JinHeMu/smart-car/README.md

# 第十八届智能视觉

本工程包含了软件，硬件和机械结构部分。软件采用RT-Thread实时操作系统，机械结构为凤凰四分类结构，工程仅供参考。
