JinHeMu/smart-car/PCB/SCH_openart显示屏转接板_1-Sheet_1_2023-07-10.png

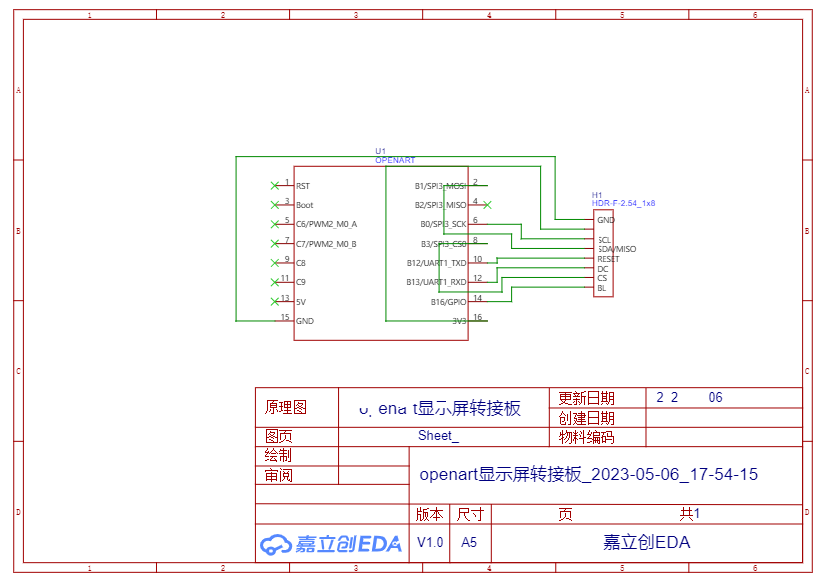
PCB/SCH_openart显示屏转接板_1-Sheet_1_2023-07-10.png
