JinHeMu/smart-car/PCB/SCH_主板_1_1-rt0164主板原理图_2023-07-10.png

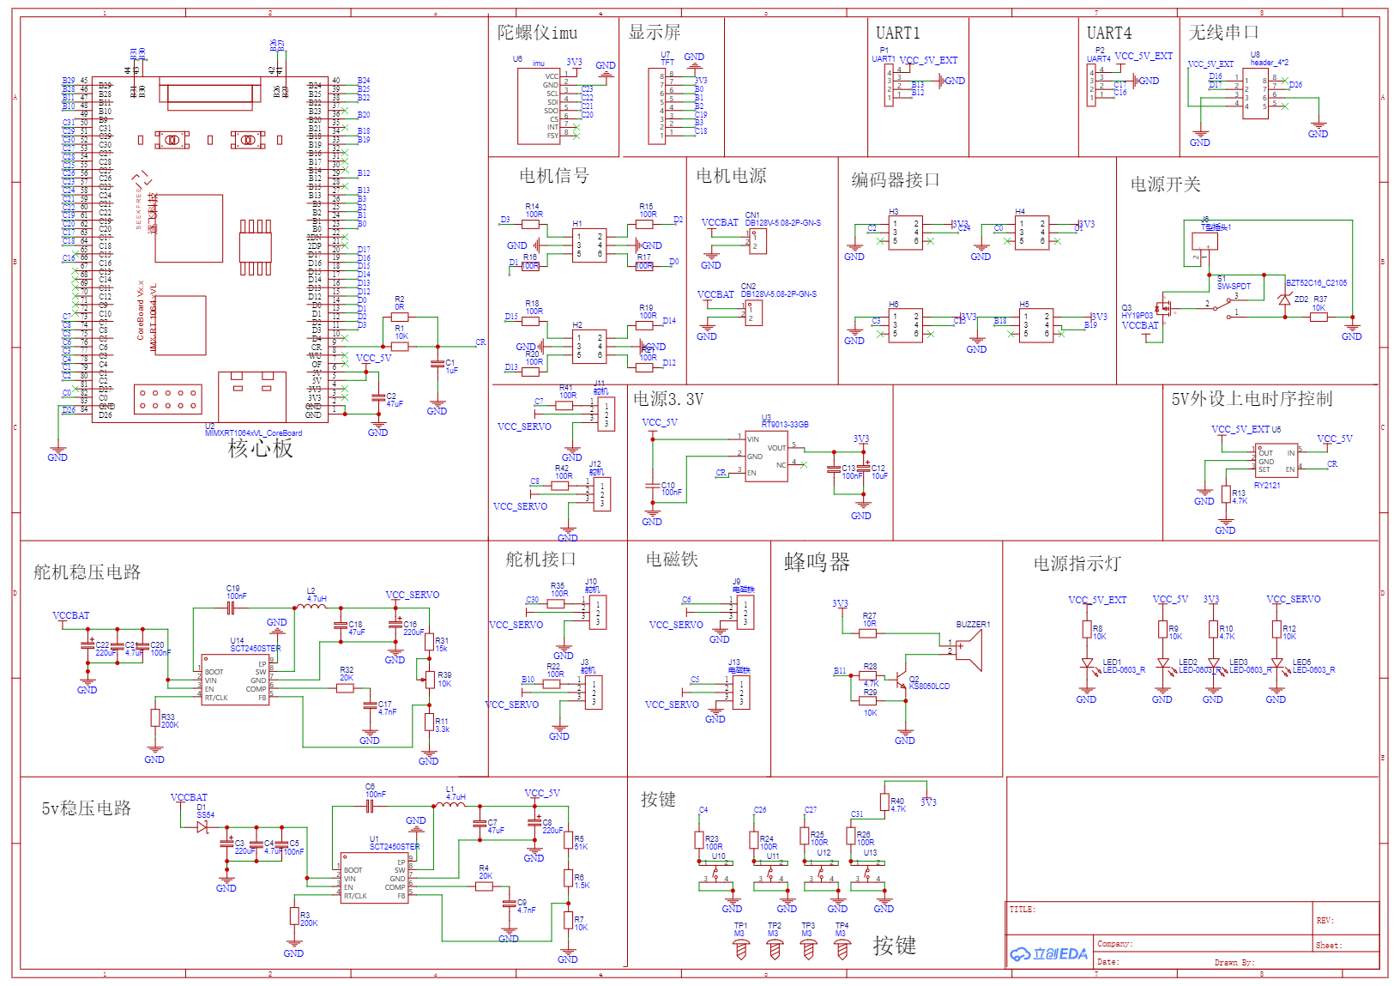
PCB/SCH_主板_1_1-rt0164主板原理图_2023-07-10.png
