JinHeMu/smart-car/PCB/SCH_主板_2_2-rt0164主板原理图_2023-08-16.png

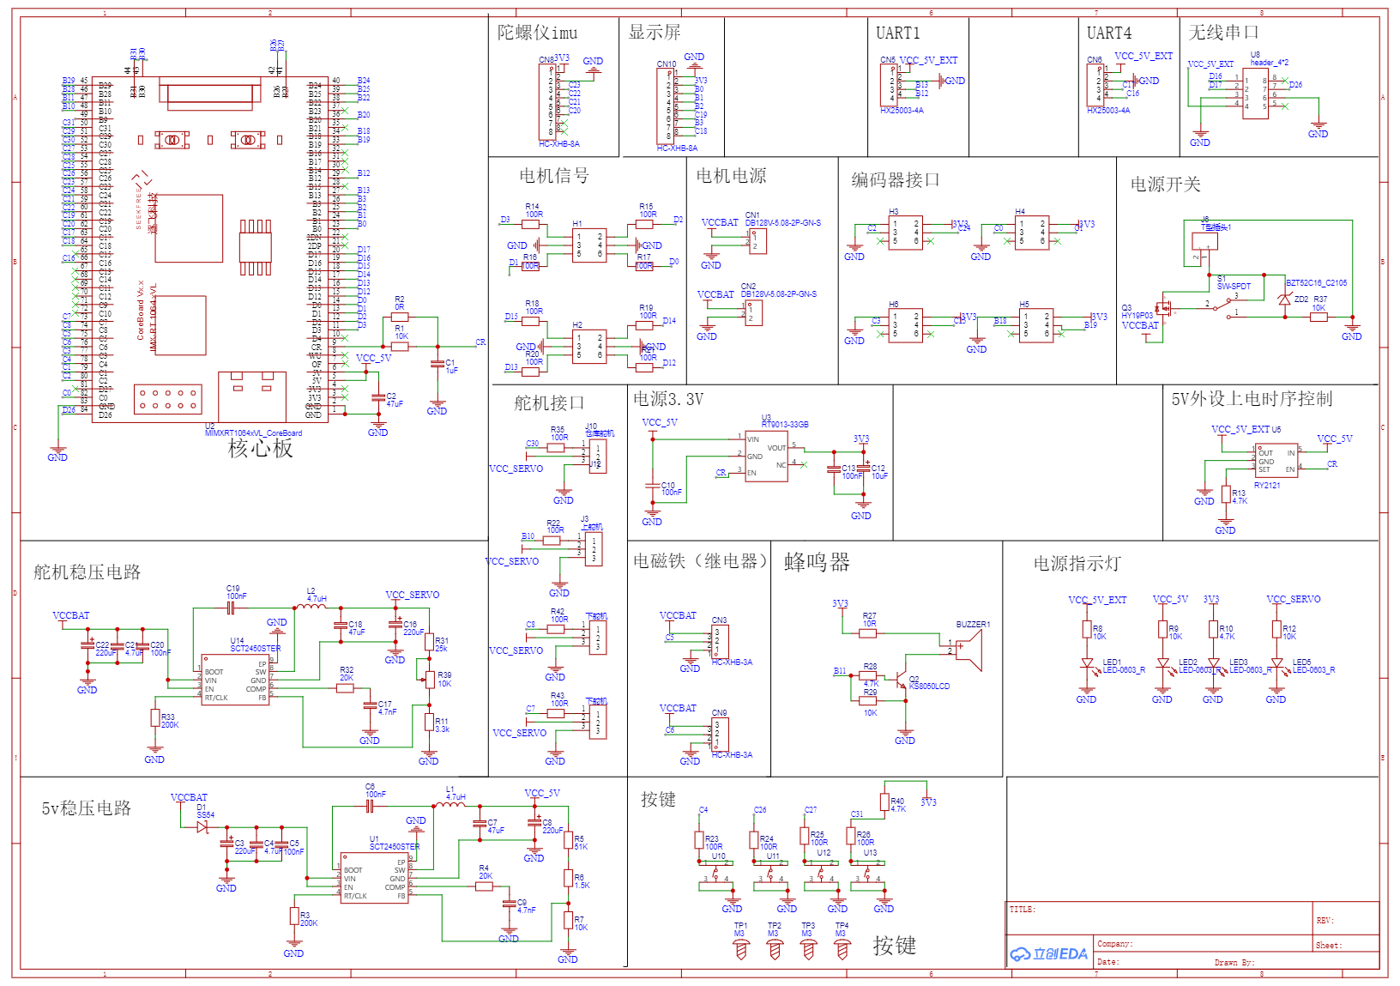
PCB/SCH_主板_2_2-rt0164主板原理图_2023-08-16.png
