JinHeMu/smart-car/PCB/SCH_驱动板_1-DRV8701_2023-07-10.png

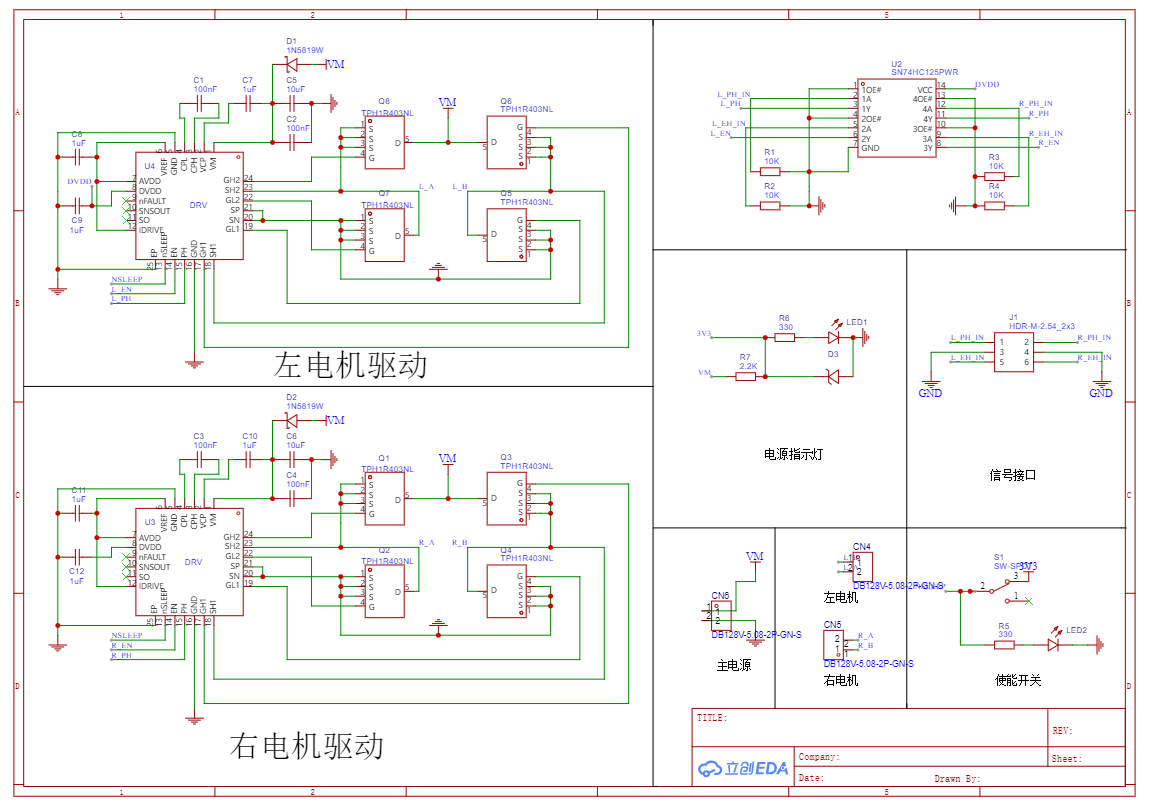
PCB/SCH_驱动板_1-DRV8701_2023-07-10.png
