JinHeMu/smart-car/PCB/继电器原理图.png

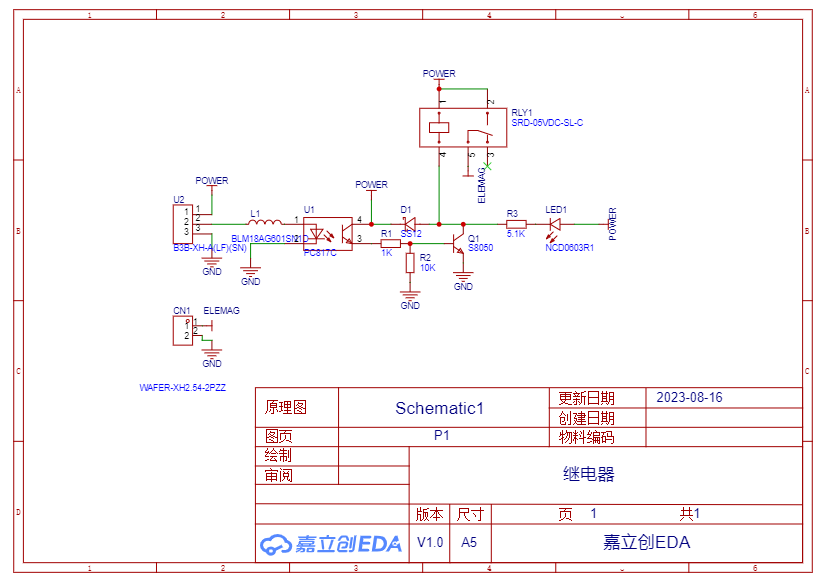
PCB/继电器原理图.png
