JinHeMu/smart-car/model/智能视觉车四分类/仓门.SLDPRT

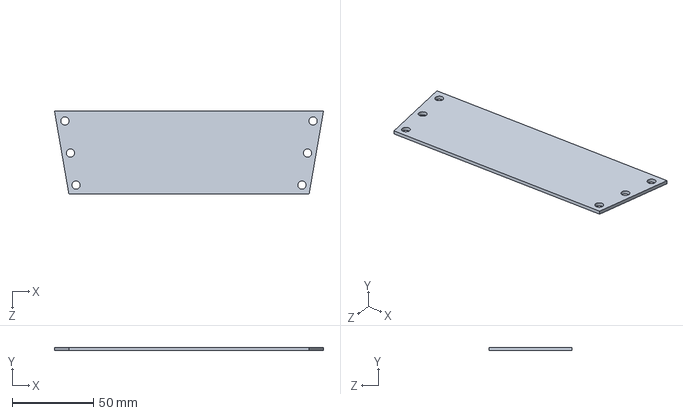
[picture p7: CAD file, 2023-07-11]
model/智能视觉车四分类/仓门.SLDPRT
165.5 x 2.00 x 50.8 mm
