JinHeMu/smart-car/model/智能视觉车四分类/储物仓.SLDPRT

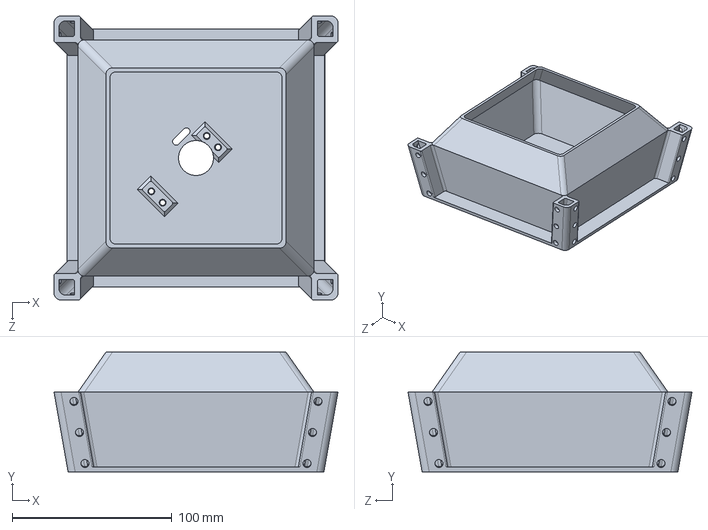
[picture p8: CAD file, 2023-07-11]
model/智能视觉车四分类/储物仓.SLDPRT
177.6 x 75.0 x 177.6 mm
