JinHeMu/smart-car/model/智能视觉车四分类/电池.SLDPRT

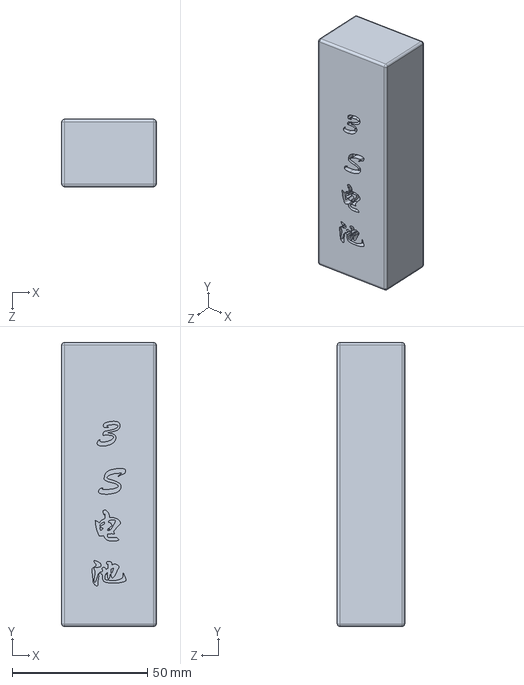
[picture p9: CAD file, 2023-06-17]
model/智能视觉车四分类/电池.SLDPRT
35.0 x 105.0 x 25.0 mm
