JinHeMu/smart-car/model/智能视觉车四分类/舵机1.SLDPRT

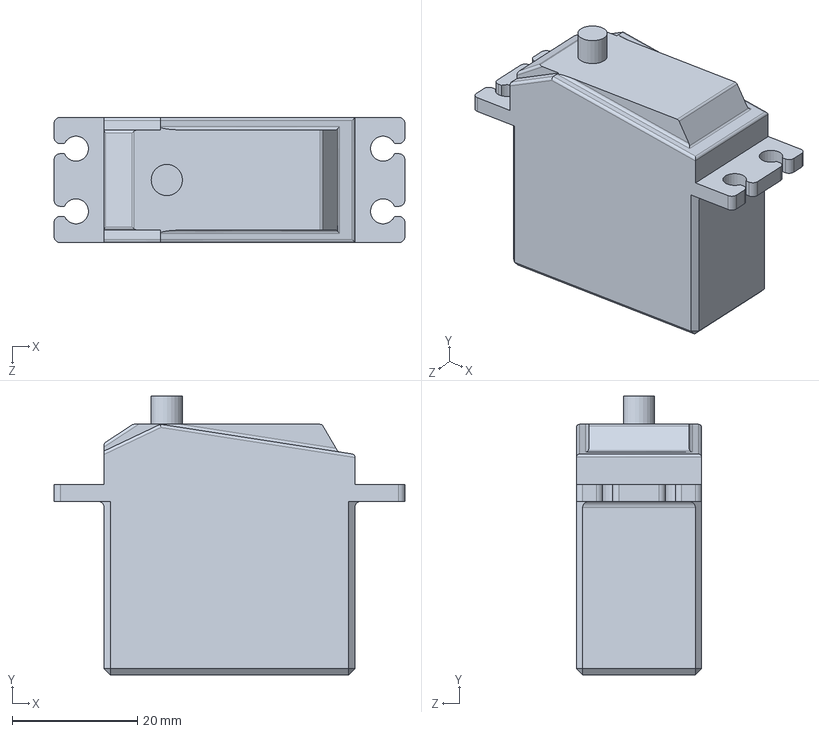
[picture p10: CAD file, 2023-06-17]
model/智能视觉车四分类/舵机1.SLDPRT
56.0 x 44.5 x 20.0 mm
