JinHeMu/smart-car/model/智能视觉车四分类/电路板底板.SLDPRT

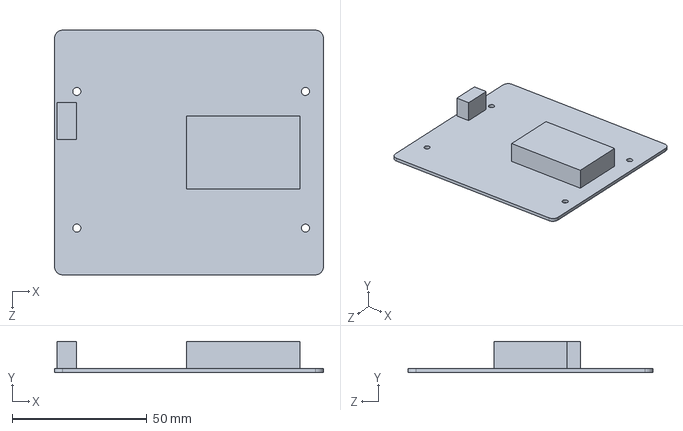
[picture p11: CAD file, 2023-06-17]
model/智能视觉车四分类/电路板底板.SLDPRT
100.0 x 11.6 x 91.0 mm
