JinHeMu/smart-car/model/智能视觉车四分类/摄像头支架2pvc.SLDPRT

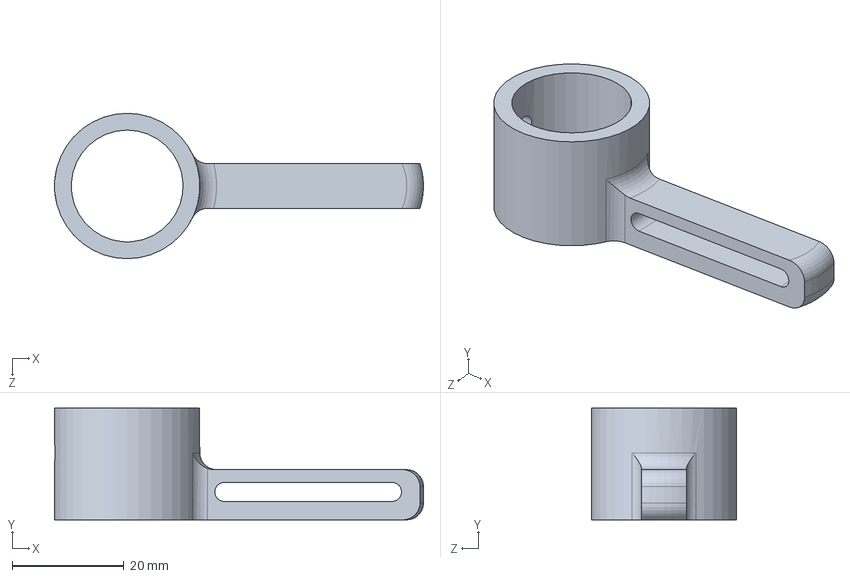
[picture p12: CAD file, 2023-06-17]
model/智能视觉车四分类/摄像头支架2pvc.SLDPRT
66.0 x 20.0 x 26.0 mm
