JinHeMu/smart-car/model/智能视觉车四分类/左侧支架.SLDPRT

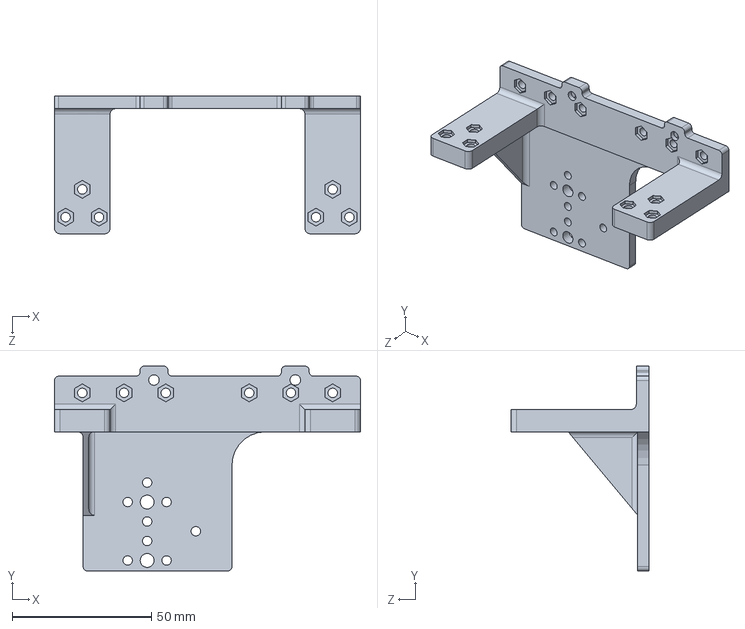
[picture p13: CAD file, 2023-06-17]
model/智能视觉车四分类/左侧支架.SLDPRT
110.0 x 73.6 x 49.5 mm
