JinHeMu/smart-car/model/智能视觉车四分类/前机械臂支架.SLDPRT

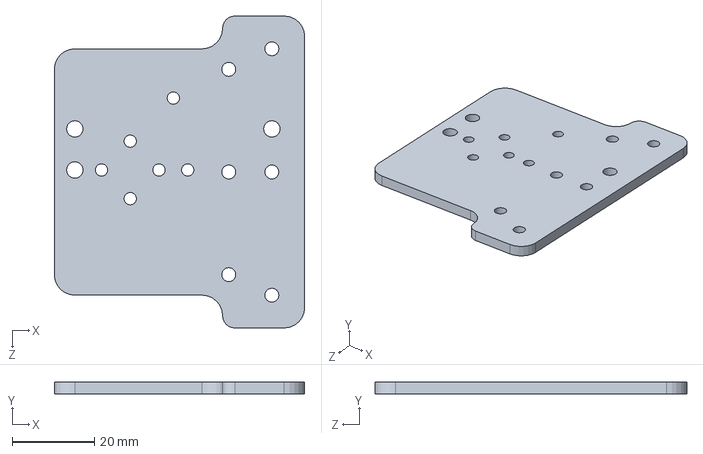
[picture p14: CAD file, 2023-06-17]
model/智能视觉车四分类/前机械臂支架.SLDPRT
61.0 x 3.00 x 76.0 mm
