JinHeMu/smart-car/model/智能视觉车四分类/卡片.SLDPRT

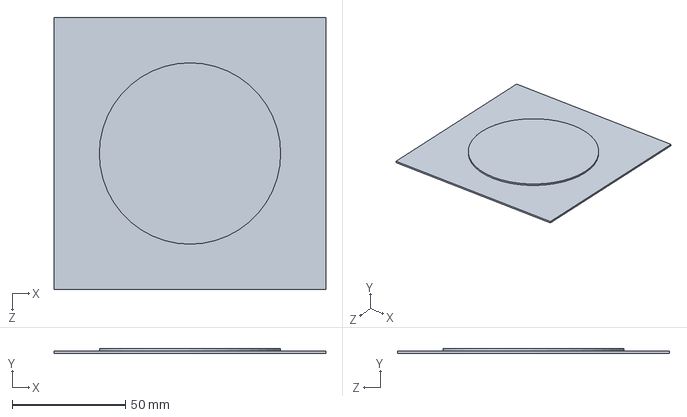
[picture p15: CAD file, 2023-06-17]
model/智能视觉车四分类/卡片.SLDPRT
120.0 x 2.00 x 120.0 mm
