JinHeMu/smart-car/model/智能视觉车四分类/M车底盘.SLDPRT

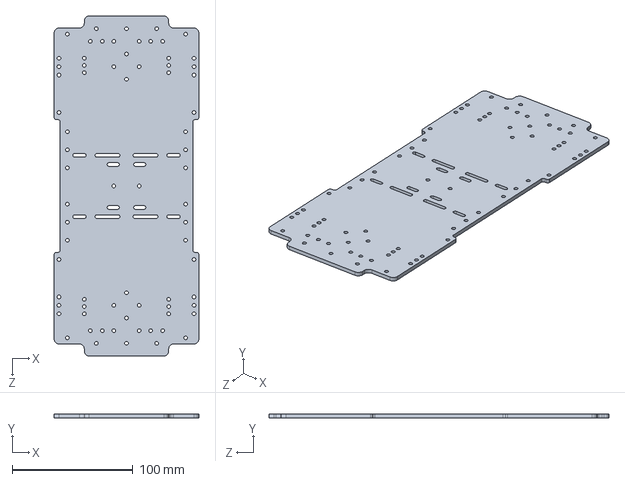
[picture p16: CAD file, 2023-06-17]
model/智能视觉车四分类/M车底盘.SLDPRT
120.0 x 3.00 x 282.0 mm
