JinHeMu/smart-car/model/智能视觉车四分类/长U支架.SLDPRT

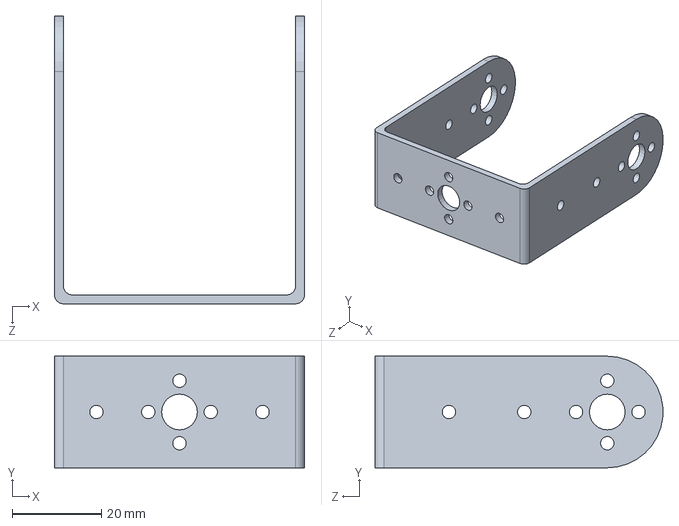
[picture p17: CAD file, 2023-06-17]
model/智能视觉车四分类/长U支架.SLDPRT
56.0 x 25.0 x 64.4 mm
