JinHeMu/smart-car/model/智能视觉车四分类/推力轴承.SLDPRT

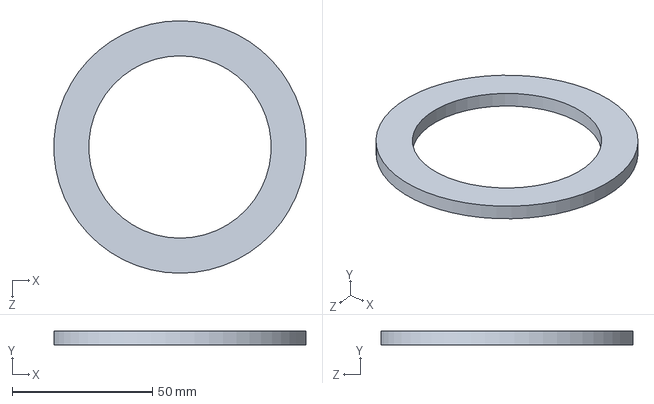
[picture p18: CAD file, 2023-06-17]
model/智能视觉车四分类/推力轴承.SLDPRT
89.8 x 5.00 x 90.0 mm
