JinHeMu/smart-car/model/智能视觉车四分类/逐飞摄像头支架连接件.SLDPRT

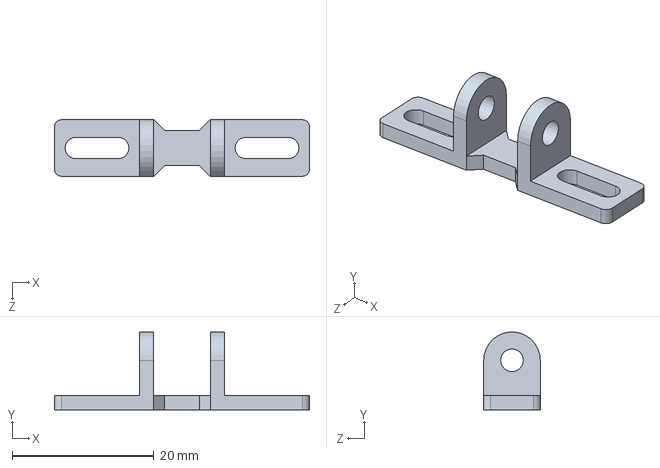
[picture p19: CAD file, 2023-06-17]
model/智能视觉车四分类/逐飞摄像头支架连接件.SLDPRT
36.0 x 11.0 x 8.00 mm
