JinHeMu/smart-car/model/智能视觉车四分类/万能支架.SLDPRT

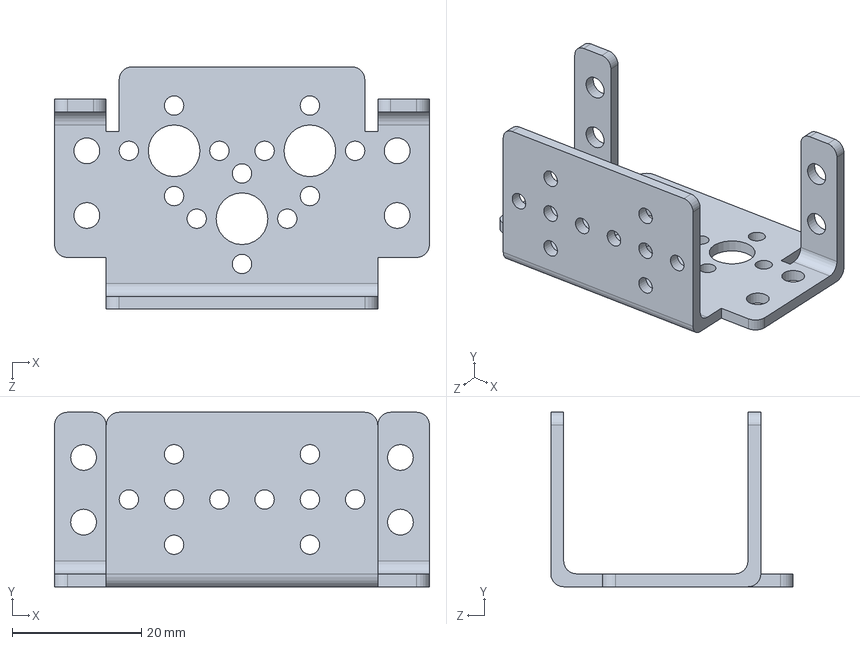
[picture p20: CAD file, 2023-06-17]
model/智能视觉车四分类/万能支架.SLDPRT
58.0 x 27.0 x 37.5 mm
