JinHeMu/smart-car/model/智能视觉车四分类/储物仓支架.SLDPRT

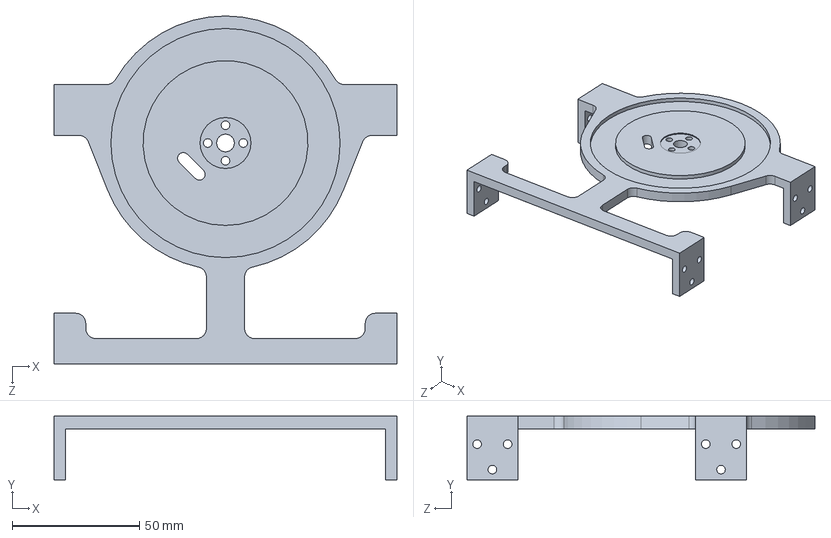
[picture p21: CAD file, 2023-06-17]
model/智能视觉车四分类/储物仓支架.SLDPRT
135.0 x 25.0 x 137.0 mm
