JinHeMu/smart-car/model/智能视觉车四分类/pvc管.SLDPRT

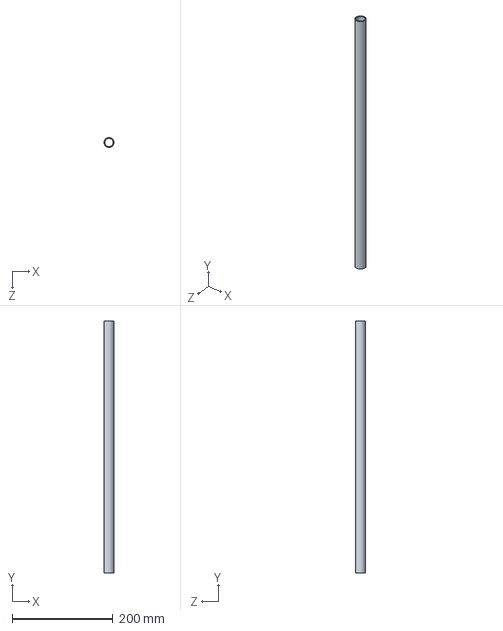
[picture p22: CAD file, 2023-06-17]
model/智能视觉车四分类/pvc管.SLDPRT
20.0 x 500.0 x 20.0 mm
