JinHeMu/smart-car/model/智能视觉车四分类/右侧支架.SLDPRT

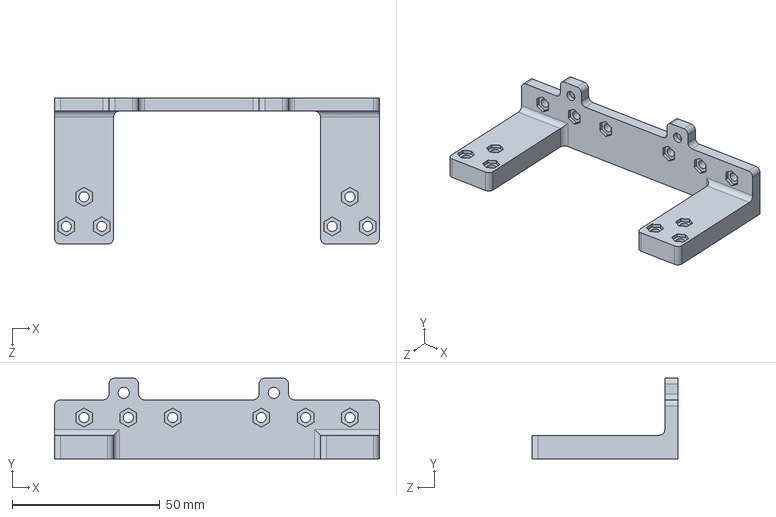
[picture p23: CAD file, 2023-06-17]
model/智能视觉车四分类/右侧支架.SLDPRT
110.0 x 27.4 x 49.5 mm
