JinHeMu/smart-car/model/智能视觉车四分类/摄像头支架1pvc.SLDPRT

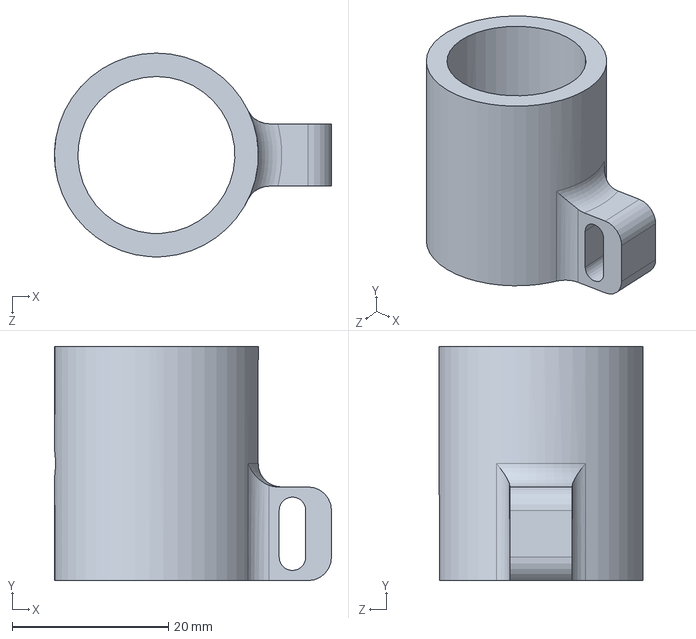
[picture p24: CAD file, 2023-06-17]
model/智能视觉车四分类/摄像头支架1pvc.SLDPRT
35.5 x 30.0 x 26.1 mm
