JinHeMu/smart-car/model/智能视觉车四分类/摄像头支架底pvc.SLDPRT

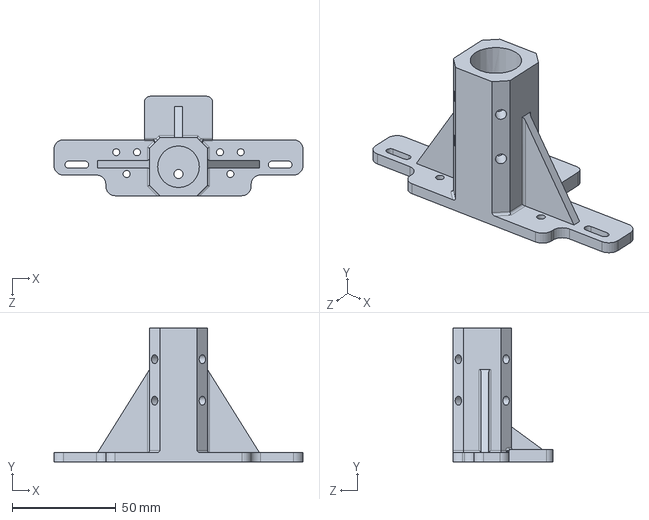
[picture p25: CAD file, 2023-06-17]
model/智能视觉车四分类/摄像头支架底pvc.SLDPRT
120.0 x 64.5 x 48.0 mm
