JinHeMu/smart-car/model/智能视觉车四分类/电磁铁.SLDPRT

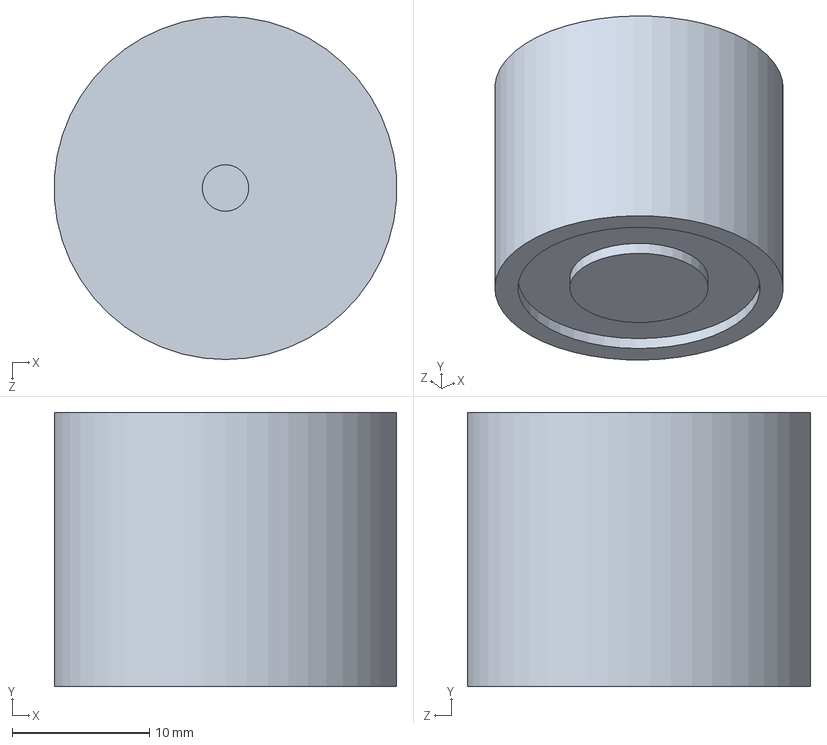
[picture p26: CAD file, 2023-06-17]
model/智能视觉车四分类/电磁铁.SLDPRT
25.0 x 20.0 x 25.0 mm
