JinHeMu/smart-car/model/智能视觉车四分类/杯式轴承.SLDPRT

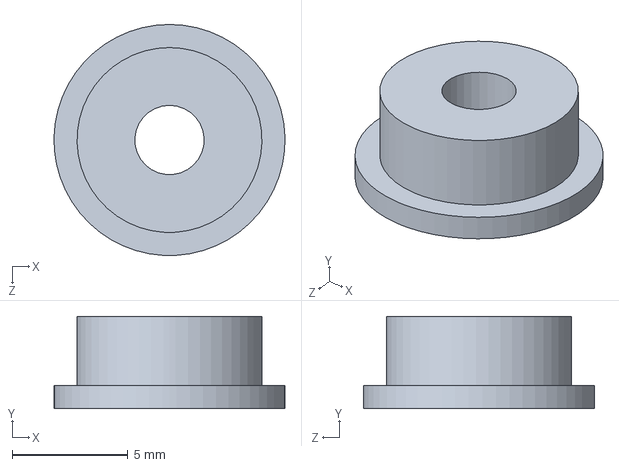
[picture p27: CAD file, 2023-06-17]
model/智能视觉车四分类/杯式轴承.SLDPRT
10.00 x 4.00 x 10.0 mm
