JinHeMu/smart-car/model/智能视觉车四分类/电磁铁支架.SLDPRT

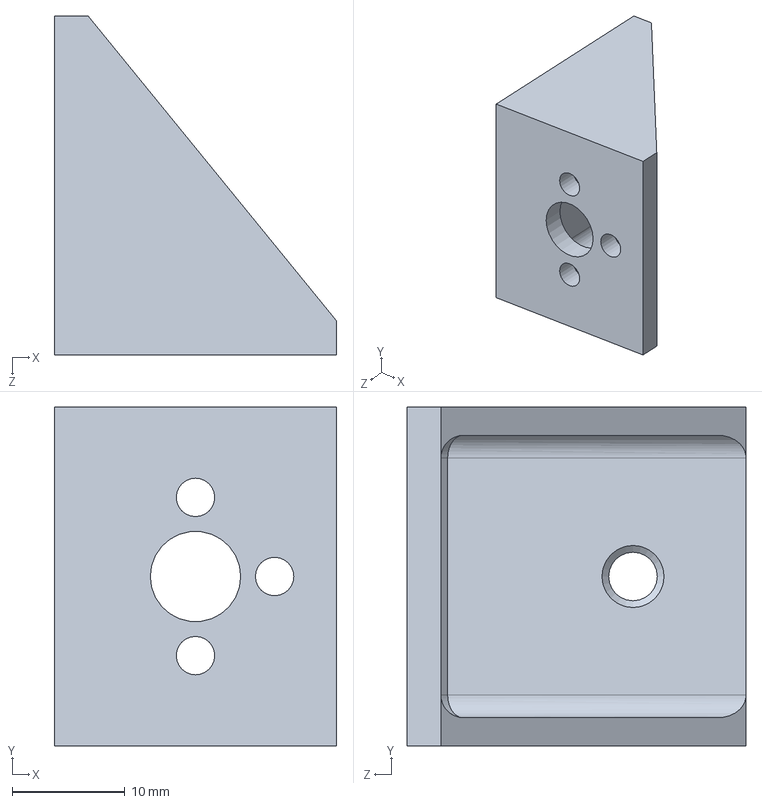
[picture p28: CAD file, 2023-06-17]
model/智能视觉车四分类/电磁铁支架.SLDPRT
25.0 x 30.0 x 30.0 mm
