JinHeMu/smart-car/model/智能视觉车四分类/pvc三通.SLDPRT

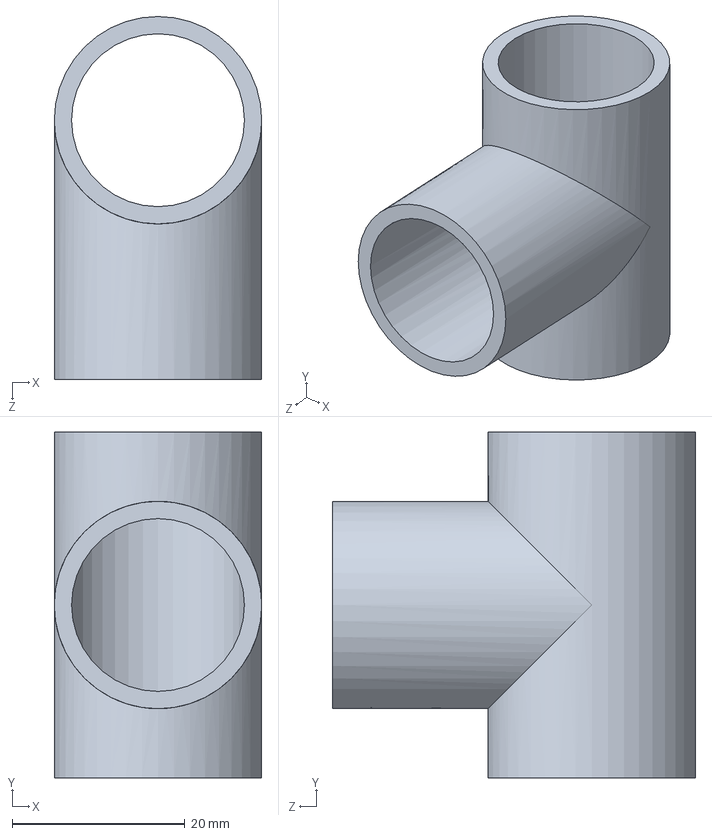
[picture p29: CAD file, 2023-06-17]
model/智能视觉车四分类/pvc三通.SLDPRT
24.0 x 40.0 x 42.0 mm
