JinHeMu/smart-car/model/智能视觉车四分类/电池扣.SLDPRT

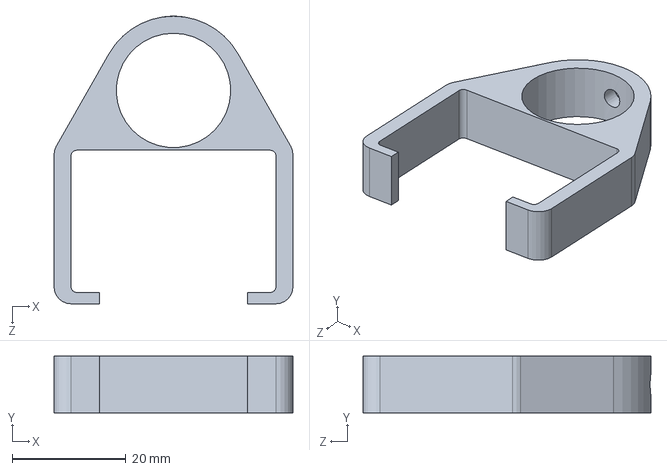
[picture p30: CAD file, 2023-06-17]
model/智能视觉车四分类/电池扣.SLDPRT
42.0 x 10.0 x 50.6 mm
