JinHeMu/smart-car/model/智能视觉车四分类/电机替代.SLDPRT

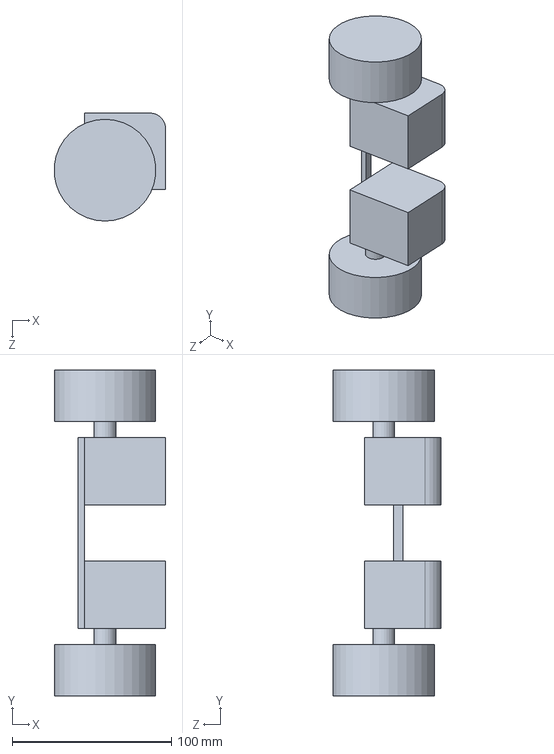
[picture p31: CAD file, 2023-06-17]
model/智能视觉车四分类/电机替代.SLDPRT
70.1 x 205.0 x 68.0 mm
