JinHeMu/smart-car/model/智能视觉车四分类/舵盘.SLDPRT

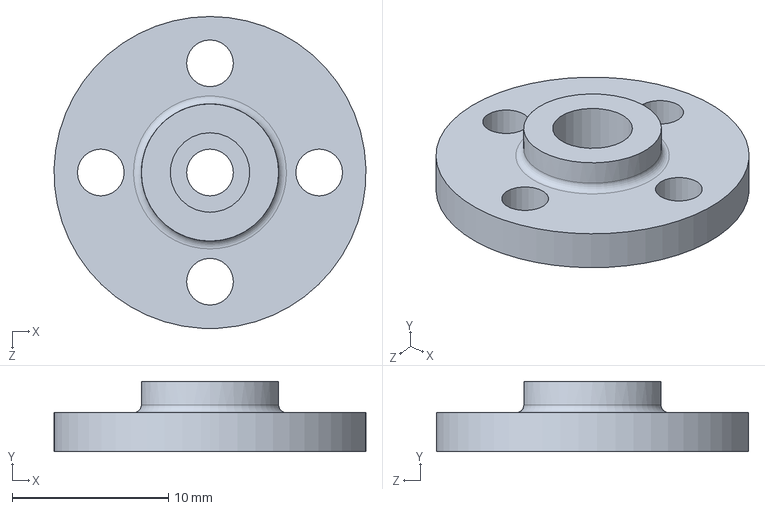
[picture p32: CAD file, 2023-06-17]
model/智能视觉车四分类/舵盘.SLDPRT
20.0 x 4.50 x 20.0 mm
