JinHeMu/smart-car/model/智能视觉车四分类/短U支架.SLDPRT

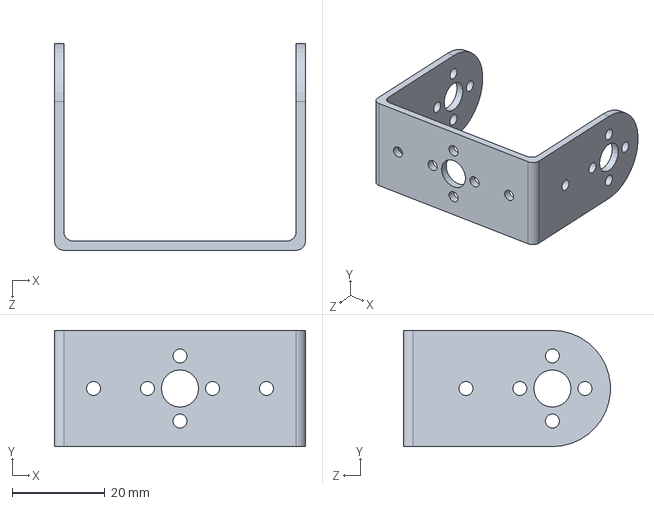
[picture p33: CAD file, 2023-06-17]
model/智能视觉车四分类/短U支架.SLDPRT
54.0 x 25.0 x 44.5 mm
