JinHeMu/smart-car/OpenArt/snapshot.py

import os, tf
from pyb import LED
from machine import UART
import utime
import seekfree
import math
import sensor, image, time

lcd = seekfree.LCD180(2)#閺勫墽銇氱仦锟�
lcd.full()

#LED(4).on()#閻撗勬


threshold = [(80, 100, -128, 127, -128, 127)]

def openart_init():

    sensor.reset()
    sensor.set_pixformat(sensor.RGB565)
    sensor.set_framesize(sensor.QVGA)
    sensor.set_brightness(500)
    sensor.skip_frames(20)
    sensor.set_auto_gain(False)
    sensor.set_auto_whitebal(False,(0,0,0))


#for i in range(5):
    #img = sensor.snapshot()
    #lcd.show_image(img, 160, 120, zoom=2)
    #filename = "/picture/example%d.jpg" % i
    #img.save(filename)
    #time.sleep(1)


def snapshot(count):
    img = sensor.snapshot()
    for b in img.find_blobs(threshold,pixels_threshold=400,area_threshold=400,margin= 1,merge=True,invert=0):
        #corners = b.corners()

        x, y, w, h = b.rect()  # 鐠佸墽鐤嗛崜顏囶梿閸栧搫鐓欓惃鍕箯娑撳﹨顫楅崸鎰垼閸滃苯顔旀惔锔衡偓渚€鐝惔锟�

        img_copy = img.copy()
        img.draw_rectangle(b.rect(), color = (255, 0, 0), scale = 1, thickness = 2)

        img_cropped = img_copy.copy(roi=b.rect())
        lcd.show_image(img, 320, 240, zoom=2)

        # 娣囨繂鐡ㄧ憗浣稿閸氬海娈戦崶鎯у剼
        img_cropped.save("/data/grape/%d.jpg" % count)


        # img1 = img.rotation_corr(0,0,0,0,0,1,60,corners).replace(vflip=True,  hmirror=False,  transpose=False)
        #img.draw_rectangle(b.rect(), color = (255, 0, 0), scale = 1, thickness = 2)

def main():
    openart_init()
    count = 7000
    while(True):
        img = sensor.snapshot()
        snapshot(count)
        if(count % 25 == 0):
            print("WAITING!!!")
            count += 1
            time.sleep(5)
        else:
            count += 1

        print(count)



if __name__ == '__main__':
    main()
