JinHeMu/smart-car/(commit log)

2023-05-07 5/7
    优化了录制数据集的代码和矫正卡片的代码
2023-05-19 修改了矫正函数
2023-05-23 2023/5/23
    修改了坐标导致的位姿校准问题
2023-05-23 2023/5/23
    修改了增量式pid，对于每一个电机进行闭环控制
2023-05-24 2023/5/24
    修改了电机闭环控制的参数
2023-05-27 2023/5/27
    修改了部分矫正函数
2023-05-28 2023/5/28
    增加了目标检测.py文件和单片机串口接受程序
2023-05-29 2023/5/29
    优化了运动函数，优化了部分函数，删除了冗杂。
2023-06-07 2023/6/7
    1.修改了部分运动函数
    2.增加了目标检测线程
    3.增加的舵机拾取卡片的功能
2023-06-11 2023/6/11
    很有希望的一版
2023-06-17 2023/6/17
    加入了舵机分类，但是还未进行测试
    [M车底盘.SLDPRT, pvc三通.SLDPRT, pvc管.SLDPRT, 万能支架.SLDPRT, 仓门.SLDPRT, 储物仓.SLDPRT, 储物仓支架.SLDPRT, 前机械臂支架.SLDPRT]
2023-06-22 2023/6/22
    完善了机械结构
2023-06-23 2023/6/23
    删除了部分注释，使得代码看起来更加清爽，给OPENARTmain函数添加了边线矫正，目前还不知道给单片机如何进行边线矫正
2023-06-24 2023/6/24
    修改了增量式pid，并不完善，
2023-06-25 2023/6/25
    修改了电机闭环控制参数，修改了转向环参数，修改了矫正的速度
2023-06-25 2023/6/25
    修改了转向环和增量式pid的参数，未加减小加速度处理
2023-06-25 2023/6/26
    1.加入了并完善了目标检测（未调试）
    2.加入了回库线程（未调试）
    3.如何进行边线检测有待思考
2023-06-26 2023/6/26
    1.给陀螺仪加入了滑动滤波处理
    2.在运动函数里加入边线矫正
    3.边线矫正作为一个优先级更高的的线程来执行（有待优化）
2023-06-26 2023/6/26
    1.修改并加入边线检测
    2.角度环还是不够稳定，需要再调
2023-06-28 2023/6/27
    完善了边线矫正
2023-06-28 2023/6/28
    1.完善了目标检测函数
    2.完善了卡片识别函数，减小识别的范围
    3.完善了OPENART2的目标检测函数
2023-06-30 1.修改了openart识别的优先级，现在会以串口中是否有数据优先级最高 2.修改了电机闭环控制的参数
2023-06-30 1.添加了边线到达函数（未验证）2.修改了目标检测函数（未验证）
2023-06-30 1.加入了测试了遍历全场，效果一般，边线矫正会有延迟，展示不知道问题在哪，还需要改进
2023-07-02 使用了ICM20602陀螺仪，大幅的减小了陀螺仪漂移
2023-07-02 修改了机械臂的运动过程
2023-07-02 加入了动态路径规划（烂版本）
2023-07-02 加入了动态路径规划（未测试版本）
2023-07-03 1.加入了动态路径规划，暂无其他问题2.修改了openart的阈值（务必注意不同亮度的阈值也会发生改变）
2023-07-03 1.修改了部分延时，提高了系统的速度
2023-07-03 修改了边线矫正函数，慢速到达边线识别边线，同时也能修改当前坐标，删除了部分函数
2023-07-03 1.修改了目标检测线程（未测试）2.修改并完善了边线检测（未测试）3.对于卡片搬运识别边线加入补偿
2023-07-04 1.修改并完善了边线矫正和搬运补偿2.优化的目标检测，但是并不完善
2023-07-04 目标检测稍微有点进展，但是存在回去位置不对，多流程数据不对，还需要优化
2023-07-04 优化并修改了分类（未测试版）
2023-07-04 验证了搬运方案，但是陀螺仪还是有点漂
2023-07-04 修改了目标检测线程，未发现程序上的问题，还需要实际测试出问题
2023-07-05 发现了目标检测的问题，舵机的磁铁也会被判断成卡片，之后需要注意机械臂的角度问题
2023-07-06 1.修改了机械臂的动作，防止储物仓卡住2.修正了陀螺仪的零漂，现在非常的稳，巨大的进步
2023-07-06 基本实现出目标检测外的功能，还需要优化的版本
2023-07-07 修改了场地大小为7*5,修改了舵机的运动函数，修改了A4纸识别，提高准确度，
2023-07-07 修改了一些参数
2023-07-08 修改了舵机的运动，优化了通讯
2023-07-08 比较完善的版本，比较远的时候，编码器的值会不精准，从而出现问题
2023-07-08 比较丝滑的版本，机械臂和各个流程之间可以优化
2023-07-09 修改了视觉部分，将130度的摄像头作为矫正
2023-07-09 修改了目标检测，修改了结构，将openart往前移，目前主要问题是里程计不太准，需要补偿
2023-07-09 修改了坐标补偿，现在非常丝滑，机械臂的动作和回库还需要修改，卡片准确率也需要提升
2023-07-11 目标检测有一定的问题
2023-07-11 非常丝滑的版本，修改了位置式pid，现在非常丝滑，扫图还有一定的问题
2023-07-11 初赛完赛版本（仓门无法打开，还是有一定的问题）
    [仓门.SLDPRT, 储物仓.SLDPRT]
2023-07-12 完赛版本（初赛）
2023-07-12 完赛版本（决赛分类目标检测还需改进）
2023-07-16 东北赛区第四，勉强应该能进全国总决赛，但是深知距离强队还有很大差距，还需逐渐提升
2023-07-20 更新了README
2023-07-24 1.添加了识别最近卡片函数2.修改了识别卡片色块时会识别到边线（未验证）3.添加启动时缓慢加速函数（未验证）
2023-07-24 添加了六分类（未验证版本）
2023-07-25 1.添加了目标检测函数，效果比较好
2023-07-26 大幅度修改了控制函数，优化了边线补偿和目标检测，但是都没有验证
2023-08-01 完善了机械机构，修改了驱动代码，基本上结构和驱动部分已经完善
2023-08-08 可以实现目标检测功能，但是需要改善
    [BOM_主板_1_PCB_主板_1_2023-07-21.xlsx, BOM_驱动板_DRV8701_2023-07-21.xlsx]
2023-08-08 完善了运动函数，还未调试，目标检测决定使用qqvga，但是也未进行调试
2023-08-10 完赛了目标检测，比较丝滑，但是存在平行的卡片无法同时识别的问题，没有优化舵机等结构
    [BOM_主板_1_PCB_主板_1_2023-07-21.xlsx]
2023-08-11 完善了目标检测，需要修改的还是防止多次识别，如何将视野内所有卡片都识别并且记录准确位置
2023-08-16 决赛版本
2023-08-16 最后一舞
2023-08-18 2023/8/19 国赛结束
    [BOM_主板_1_PCB_主板_1_2023-04-13.xlsx, BOM_驱动板_2023-03-11.csv, BOM_驱动板_DRV8701_2023-07-21.xlsx, M车底盘.SLDPRT, cmm_cfg.csv, pvc三通.SLDPRT, pvc管.SLDPRT, 万能支架.SLDPRT]
2023-08-18 更新四分类
    [M车底盘.SLDPRT, pvc三通.SLDPRT, pvc管.SLDPRT, 万能支架.SLDPRT, 仓门.SLDPRT, 储物仓.SLDPRT, 储物仓支架.SLDPRT, 前机械臂支架.SLDPRT]
2023-09-20 添加学习经历，删减了不必要的文件
