JinHeMu/smart-car/(notices)

Notices in the files:
Project/USER/inc/RT106X_config.h:
Copyright (c) 2019,Öð·É¿Æ¼¼
All rights reserved.
Project/CODE/demo/imu660.c:
Copyright (c) 2022 SEEKFREE Öð·É¿Æ¼¼
